BME-IIT-robotcsapat/iit-smallomni-pcb/iit-smallomni.pdf

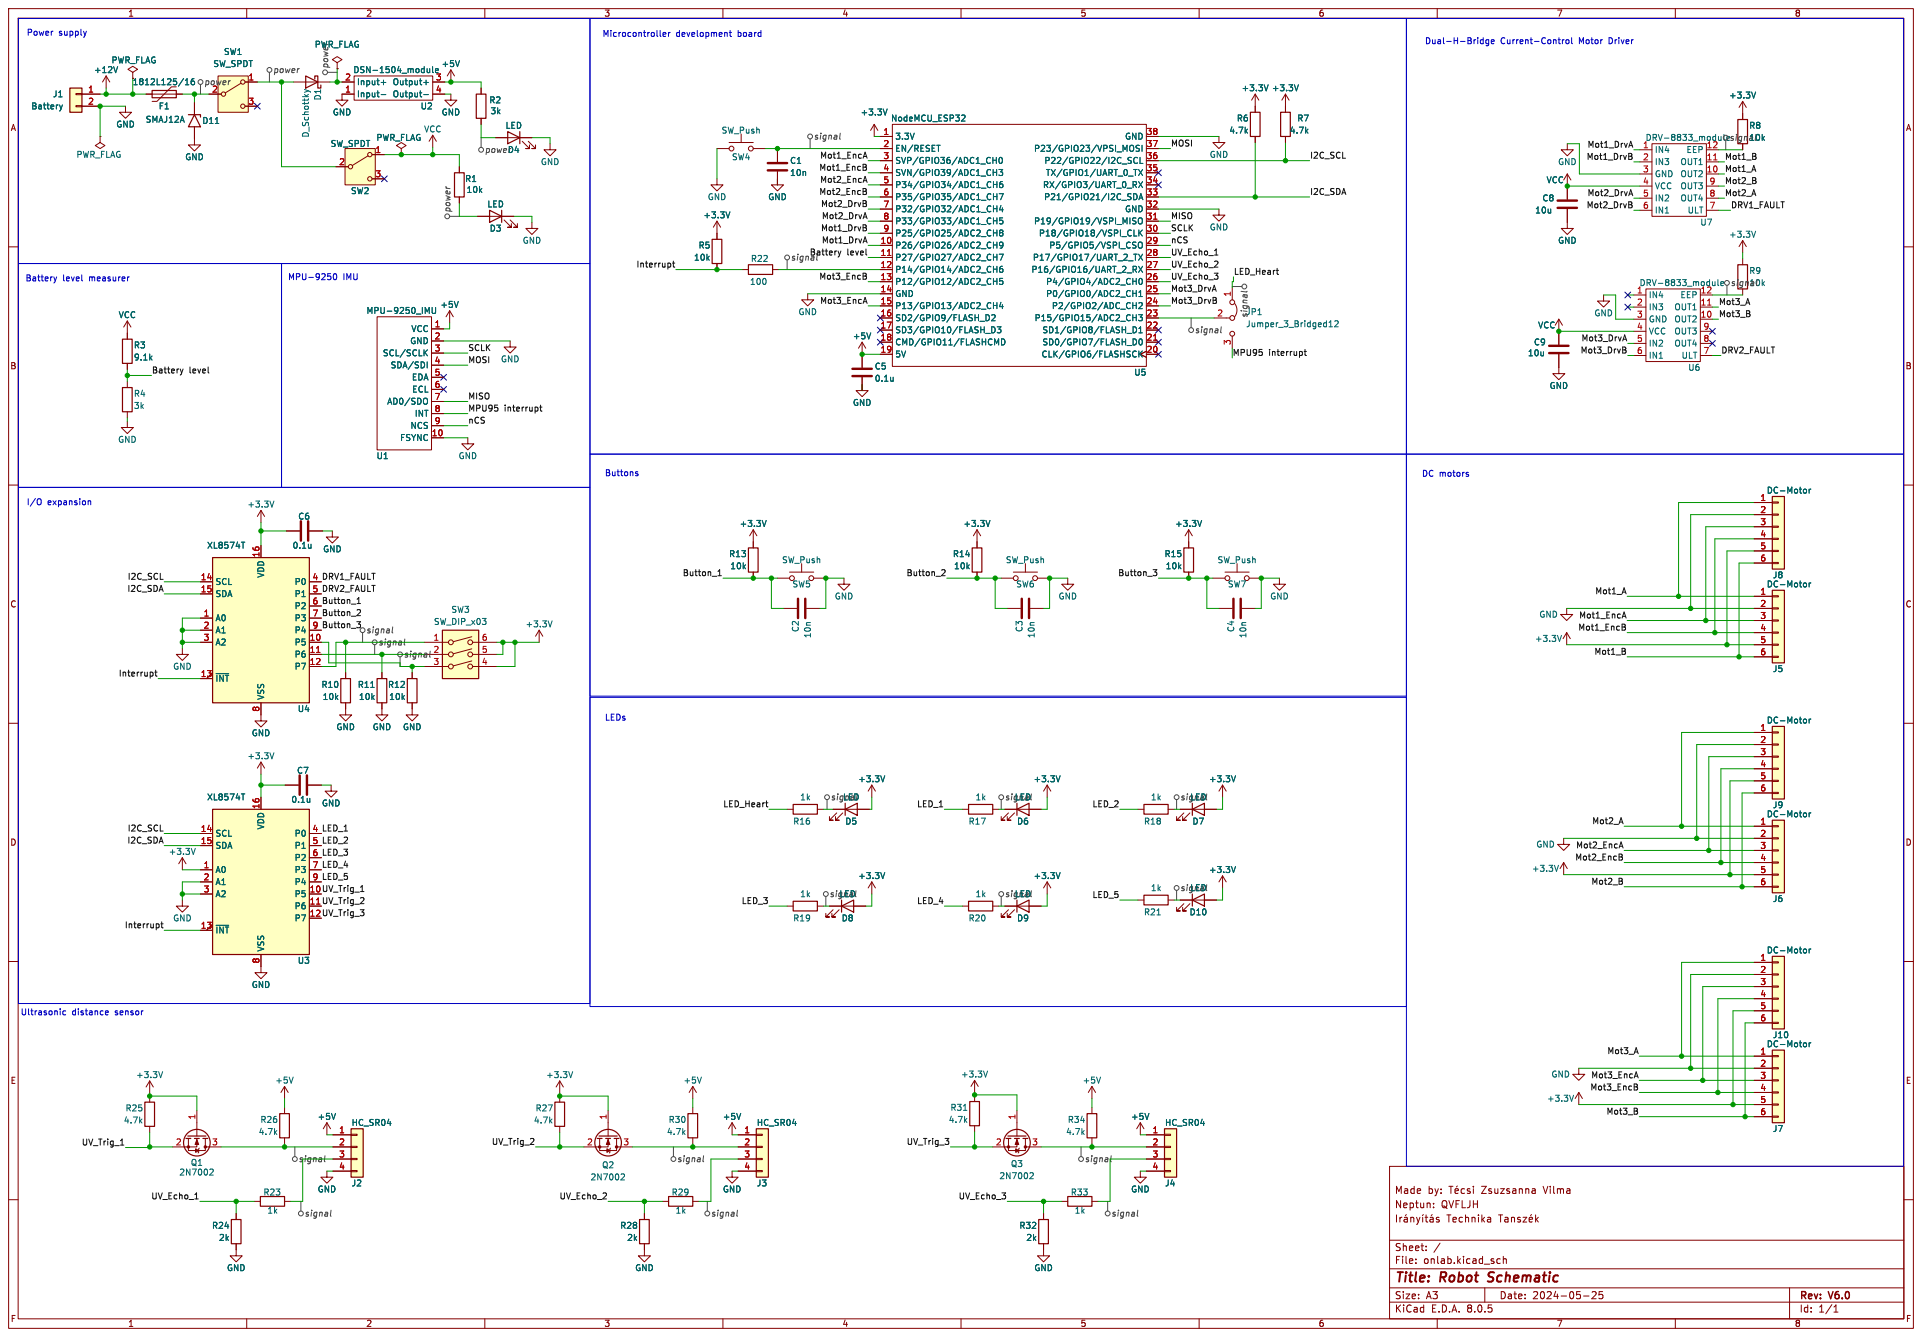
[picture p1: page 1]

LED
U1 MPU-9250_IMU
VCC 1 FSYNC 10 GND 2 SCL/SCLK 3 SDA/SDI 4 EDA 5 ECL 6 AD0/SDO 7

Id: 1/1 Title: Robot Schematic
