BME-IIT-robotcsapat/iit-smallomni-pcb/iit-smallomni.kicad_pcb

## KiCad design iit-smallomni.kicad_pcb (2025-07-06)

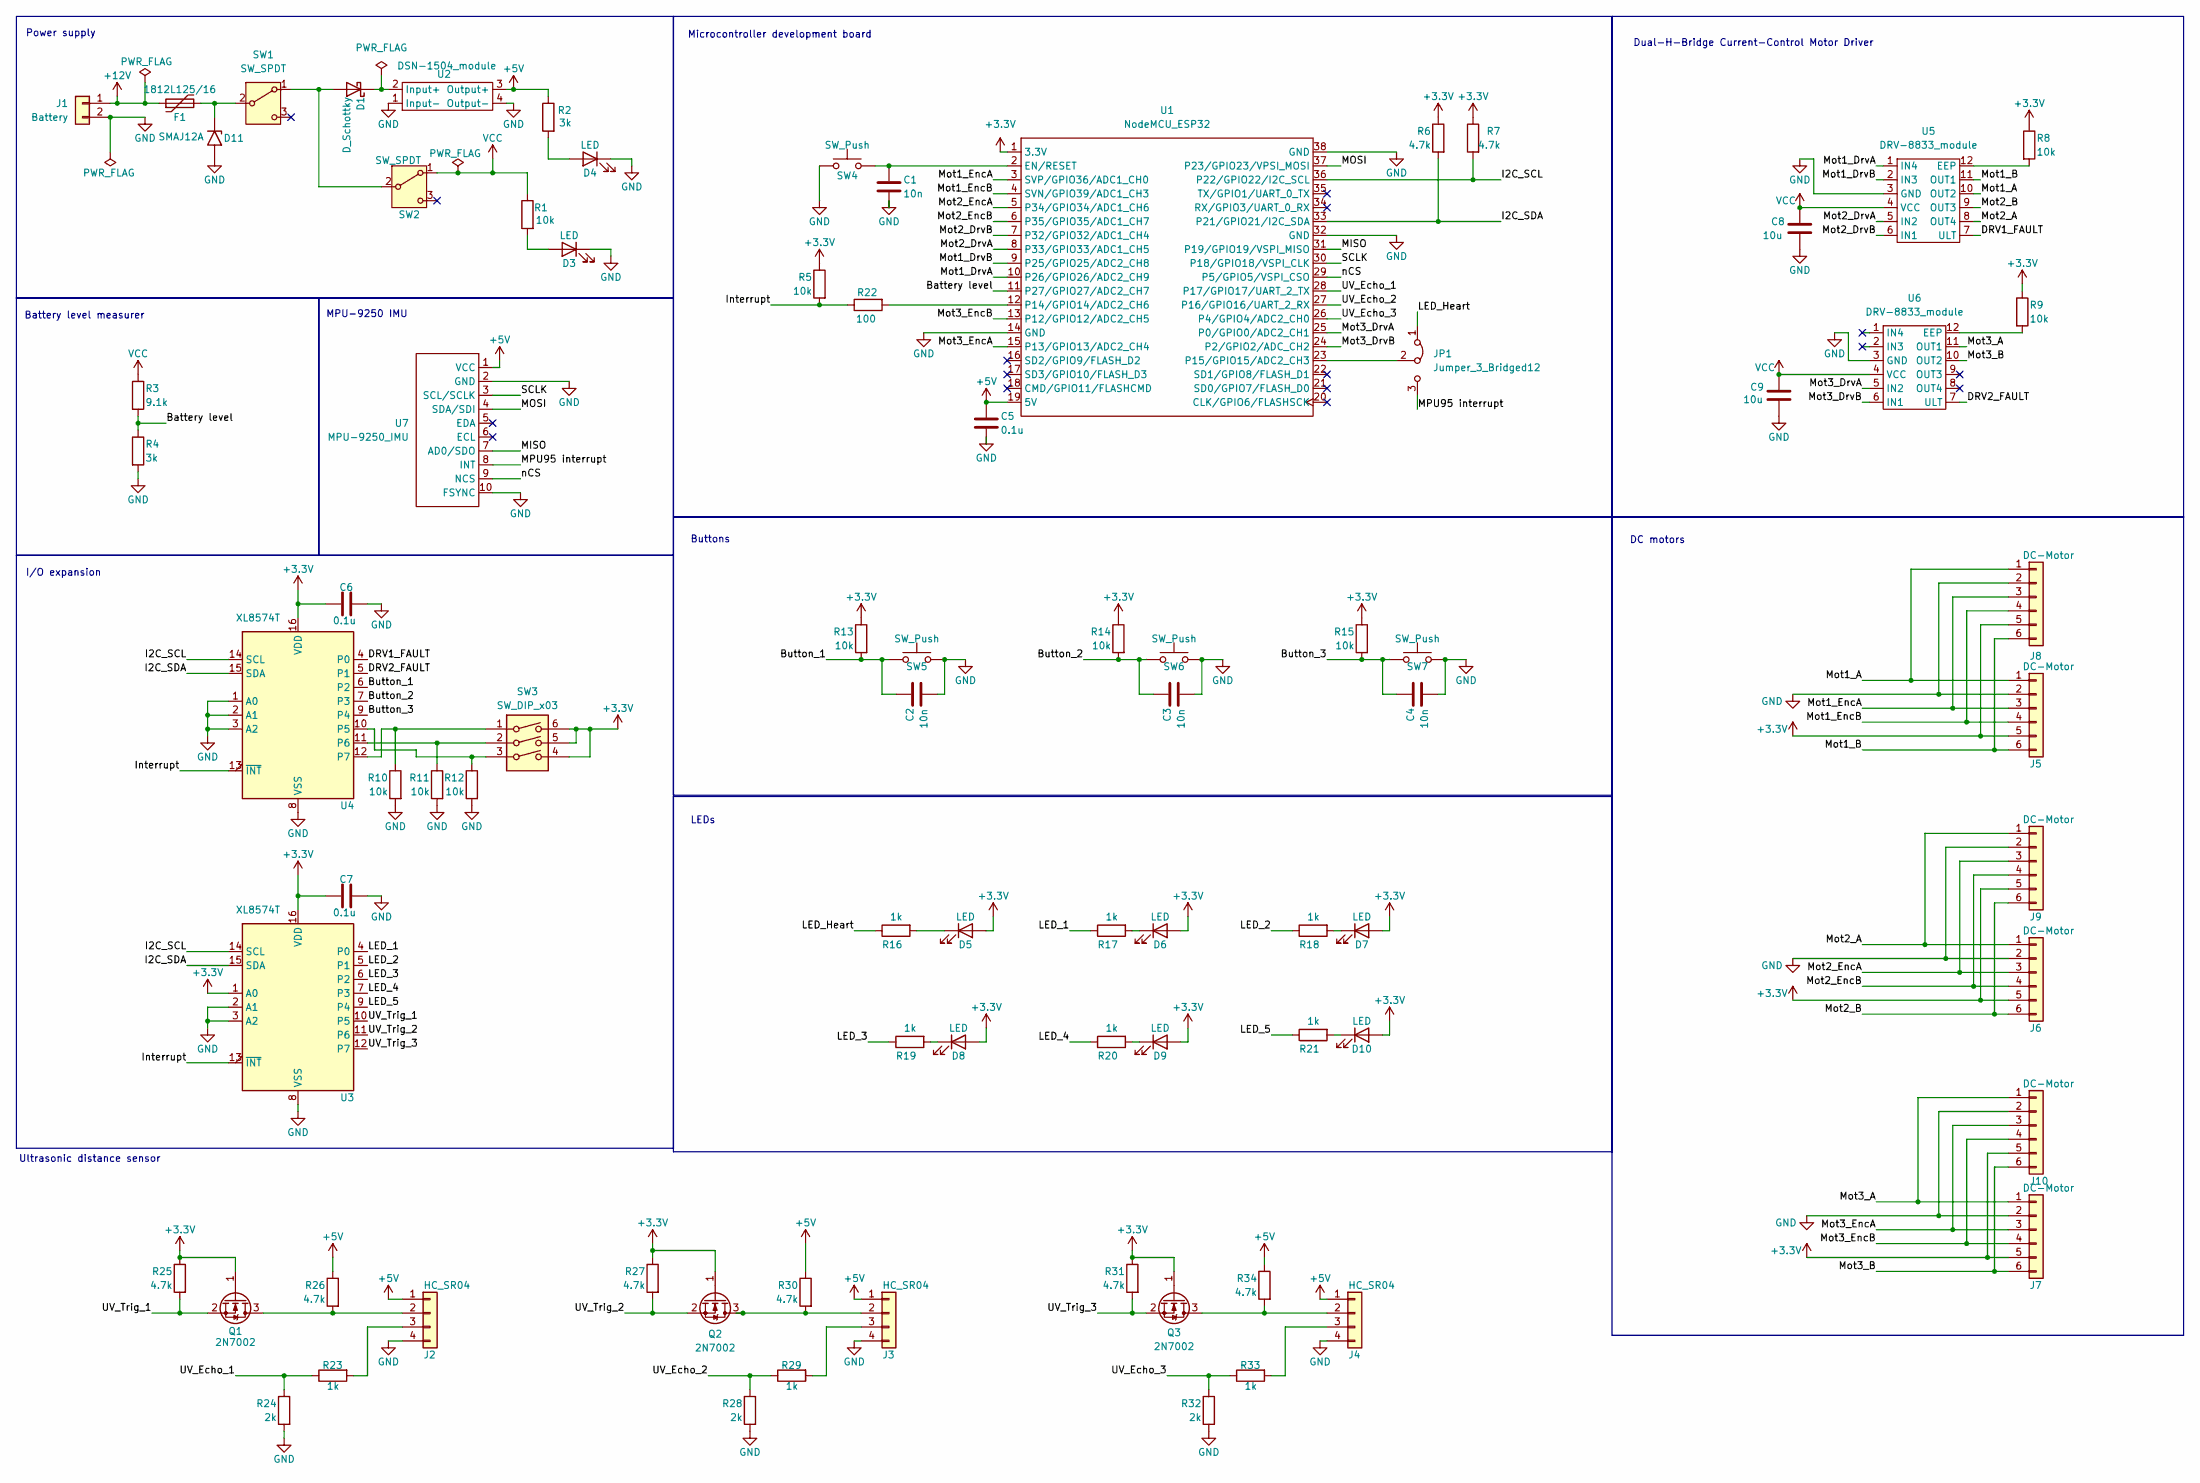
[picture p2: schematic iit-smallomni.kicad_sch, Robot Schematic]

Parts:
C1, C2, C3, C4: 10n; C_0805_2012Metric_Pad1.18x1.45mm_HandSolder
C5, C6, C7: 0.1u; C_0805_2012Metric_Pad1.18x1.45mm_HandSolder
C8, C9: 10u; C_0805_2012Metric_Pad1.18x1.45mm_HandSolder
D1: D_Schottky; D_0805_2012Metric_Pad1.15x1.40mm_HandSolder
D3, D4, D5, D6, D7, D8, D9, D10: LED; LED_0805_2012Metric_Pad1.15x1.40mm_HandSolder
D11: SMAJ12A; D_SMA
F1: 1812L125/16; polyfuse
J1: Battery; Molex_KK-254_AE-6410-02A_1x02_P2.54mm_Vertical
J2, J3, J4: HC_SR04; PinSocket_1x04_P2.54mm_Vertical
J5, J6, J7: DC-Motor; Molex_KK-254_AE-6410-06A_1x06_P2.54mm_Vertical
J8, J9, J10: DC-Motor; motor
JP1: Jumper_3_Bridged12; FanPinHeader_1x03_P2.54mm_Vertical
Q1, Q2, Q3: 2N7002; SOT-23
R1, R5, R8, R9, R10, R11, R12, R13, R14, R15: 10k; R_0805_2012Metric_Pad1.20x1.40mm_HandSolder
R2, R4: 3k; R_0805_2012Metric_Pad1.20x1.40mm_HandSolder
R3: 9.1k; R_0805_2012Metric_Pad1.20x1.40mm_HandSolder
R6, R7, R25, R26, R27, R30, R31, R34: 4.7k; R_0805_2012Metric_Pad1.20x1.40mm_HandSolder
R16, R17, R18, R19, R20, R21, R23, R29, R33: 1k; R_0805_2012Metric_Pad1.20x1.40mm_HandSolder
R22: 100; R_0805_2012Metric_Pad1.20x1.40mm_HandSolder
R24, R28, R32: 2k; R_0805_2012Metric_Pad1.20x1.40mm_HandSolder
SW1, SW2: SW_SPDT; FanPinHeader_1x03_P2.54mm_Vertical
SW3: SW_DIP_x03; SW_DIP_SPSTx03_Slide_9.78x9.8mm_W7.62mm_P2.54mm
SW4, SW5, SW6, SW7: SW_Push; SW_PUSH_6mm_H5mm
U1: NodeMCU_ESP32; NodeMCU32S
U2: DSN-1504_module; DSN1504_module
U3, U4: XL8574T; SOIC-16W_7.5x10.3mm_P1.27mm
U5, U6: DRV-8833_module
U7: MPU-9250_IMU; PinSocket_1x10_P2.54mm_Vertical

Connections:
+3.3V: C6.1, C7.1, D5.2 (A), D6.2 (A), D7.2 (A), D8.2 (A), D9.2 (A), D10.2 (A), J5.5, J6.5, J7.5, J8.5, J9.5, J10.5, Q1.1 (G), Q2.1 (G), Q3.1 (G), R5.1, R6.1, R7.1, R8.1, R9.1, R13.1, R14.1, R15.1, R25.1, R27.1, R31.1, SW3.4, SW3.5, SW3.6, U1.1 (3.3V), U3.1 (A0), U3.16 (VDD), U4.16 (VDD)
+5V: C5.1, J2.1, J3.1, J4.1, R2.1, R26.1, R30.1, R34.1, U1.19 (5V), U2.3 (Output+), U7.1 (VCC)
+12V: F1.1, J1.1
/Battery level: R3.2, R4.1, U1.11 (P27/GPIO27/ADC2_CH7)
/Button_1: C2.1, R13.2, SW5.1, U4.6 (P2)
/Button_2: C3.1, R14.2, SW6.1, U4.7 (P3)
/Button_3: C4.1, R15.2, SW7.1, U4.9 (P4)
/DRV1_FAULT: U4.4 (P0), U5.7 (ULT)
/DRV2_FAULT: U4.5 (P1), U6.7 (ULT)
/I2C_SCL: R7.2, U1.36 (P22/GPIO22/I2C_SCL), U3.14 (SCL), U4.14 (SCL)
/I2C_SDA: R6.2, U1.33 (P21/GPIO21/I2C_SDA), U3.15 (SDA), U4.15 (SDA)
/Interrupt: R5.2, R22.1, U3.13 (~INT), U4.13 (~INT)
/LED_1: R17.1, U3.4 (P0)
/LED_2: R18.1, U3.5 (P1)
/LED_3: R19.1, U3.6 (P2)
/LED_4: R20.1, U3.7 (P3)
/LED_5: R21.1, U3.9 (P4)
/LED_Heart: JP1.1 (A), R16.1
/MISO: U1.31 (P19/GPIO19/VSPI_MISO), U7.7 (AD0/SDO)
/MOSI: U1.37 (P23/GPIO23/VPSI_MOSI), U7.4 (SDA/SDI)
/MPU95 interrupt: JP1.3 (B), U7.8 (INT)
/Mot1_A: J5.1, J8.1, U5.10 (OUT2)
/Mot1_B: J5.6, J8.6, U5.11 (OUT1)
/Mot1_DrvA: U1.10 (P26/GPIO26/ADC2_CH9), U5.1 (IN4)
/Mot1_DrvB: U1.9 (P25/GPIO25/ADC2_CH8), U5.2 (IN3)
/Mot1_EncA: J5.3, J8.3, U1.3 (SVP/GPIO36/ADC1_CH0)
/Mot1_EncB: J5.4, J8.4, U1.4 (SVN/GPIO39/ADC1_CH3)
/Mot2_A: J6.1, J9.1, U5.8 (OUT4)
/Mot2_B: J6.6, J9.6, U5.9 (OUT3)
/Mot2_DrvA: U1.8 (P33/GPIO33/ADC1_CH5), U5.5 (IN2)
/Mot2_DrvB: U1.7 (P32/GPIO32/ADC1_CH4), U5.6 (IN1)
/Mot2_EncA: J6.3, J9.3, U1.5 (P34/GPIO34/ADC1_CH6)
/Mot2_EncB: J6.4, J9.4, U1.6 (P35/GPIO35/ADC1_CH7)
/Mot3_A: J7.1, J10.1, U6.11 (OUT1)
/Mot3_B: J7.6, J10.6, U6.10 (OUT2)
/Mot3_DrvA: U1.25 (P0/GPIO0/ADC2_CH1), U6.5 (IN2)
/Mot3_DrvB: U1.24 (P2/GPIO2/ADC_CH2), U6.6 (IN1)
/Mot3_EncA: J7.3, J10.3, U1.15 (P13/GPIO13/ADC2_CH4)
/Mot3_EncB: J7.4, J10.4, U1.13 (P12/GPIO12/ADC2_CH5)
/SCLK: U1.30 (P18/GPIO18/VSPI_CLK), U7.3 (SCL/SCLK)
/UV_Echo_1: R23.1, R24.1, U1.28 (P17/GPIO17/UART_2_TX)
/UV_Echo_2: R28.1, R29.1, U1.27 (P16/GPIO16/UART_2_RX)
/UV_Echo_3: R32.1, R33.1, U1.26 (P4/GPIO4/ADC2_CH0)
/UV_Trig_1: Q1.2 (S), R25.2, U3.10 (P5)
/UV_Trig_2: Q2.2 (S), R27.2, U3.11 (P6)
/UV_Trig_3: Q3.2 (S), R31.2, U3.12 (P7)
/nCS: U1.29 (P5/GPIO5/VSPI_CSO), U7.9 (NCS)
GND: C1.2, C2.2, C3.2, C4.2, C5.2, C6.2, C7.2, C8.2, C9.2, D3.1 (K), D4.1 (K), D11.2 (A2), J1.2, J2.4, J3.4, J4.4, J5.2, J6.2, J7.2, J8.2, J9.2, J10.2, R4.2, R10.2, R11.2, R12.2, R24.2, R28.2, R32.2, SW4.1, SW5.2, SW6.2, SW7.2, U1.14 (GND), U1.32 (GND), U1.38 (GND), U2.1 (Input-), U2.4 (Output-), U3.2 (A1), U3.3 (A2), U3.8 (VSS), U4.1 (A0), U4.2 (A1), U4.3 (A2), U4.8 (VSS), U5.3 (GND), U6.3 (GND), U7.2 (GND), U7.10 (FSYNC)
unnamed: D1.2 (A), SW1.1 (A), SW2.2 (B)
unnamed: D1.1 (K), U2.2 (Input+)
unnamed: D3.2 (A), R1.2
unnamed: D4.2 (A), R2.2
unnamed: D5.1 (K), R16.2
unnamed: D6.1 (K), R17.2
unnamed: D7.1 (K), R18.2
unnamed: D8.1 (K), R19.2
unnamed: D9.1 (K), R20.2
unnamed: D10.1 (K), R21.2
unnamed: D11.1 (A1), F1.2, SW1.2 (B)
unnamed: J2.2, Q1.3 (D), R26.2
unnamed: J2.3, R23.2
unnamed: J3.2, Q2.3 (D), R30.2
unnamed: J3.3, R29.2
unnamed: J4.2, Q3.3 (D), R34.2
unnamed: J4.3, R33.2
unnamed: JP1.2 (C), U1.23 (P15/GPIO15/ADC2_CH3)
unnamed: C1.1, SW4.2, U1.2 (EN/RESET)
unnamed: R22.2, U1.12 (P14/GPIO14/ADC2_CH6)
unnamed: R12.1, SW3.3, U4.10 (P5)
unnamed: R11.1, SW3.2, U4.11 (P6)
unnamed: R10.1, SW3.1, U4.12 (P7)
unnamed: R8.2, U5.12 (EEP)
unnamed: R9.2, U6.12 (EEP)
VCC: C8.1, C9.1, R1.1, R3.1, SW2.1 (A), U5.4 (VCC), U6.4 (VCC)

Notes on the sheet:
Ultrasonic distance sensor
LEDs
I/O expansion
Power supply
DC motors
Microcontroller development board
MPU-9250 IMU
Dual-H-Bridge Current-Control Motor Driver
Battery level measurer
Buttons

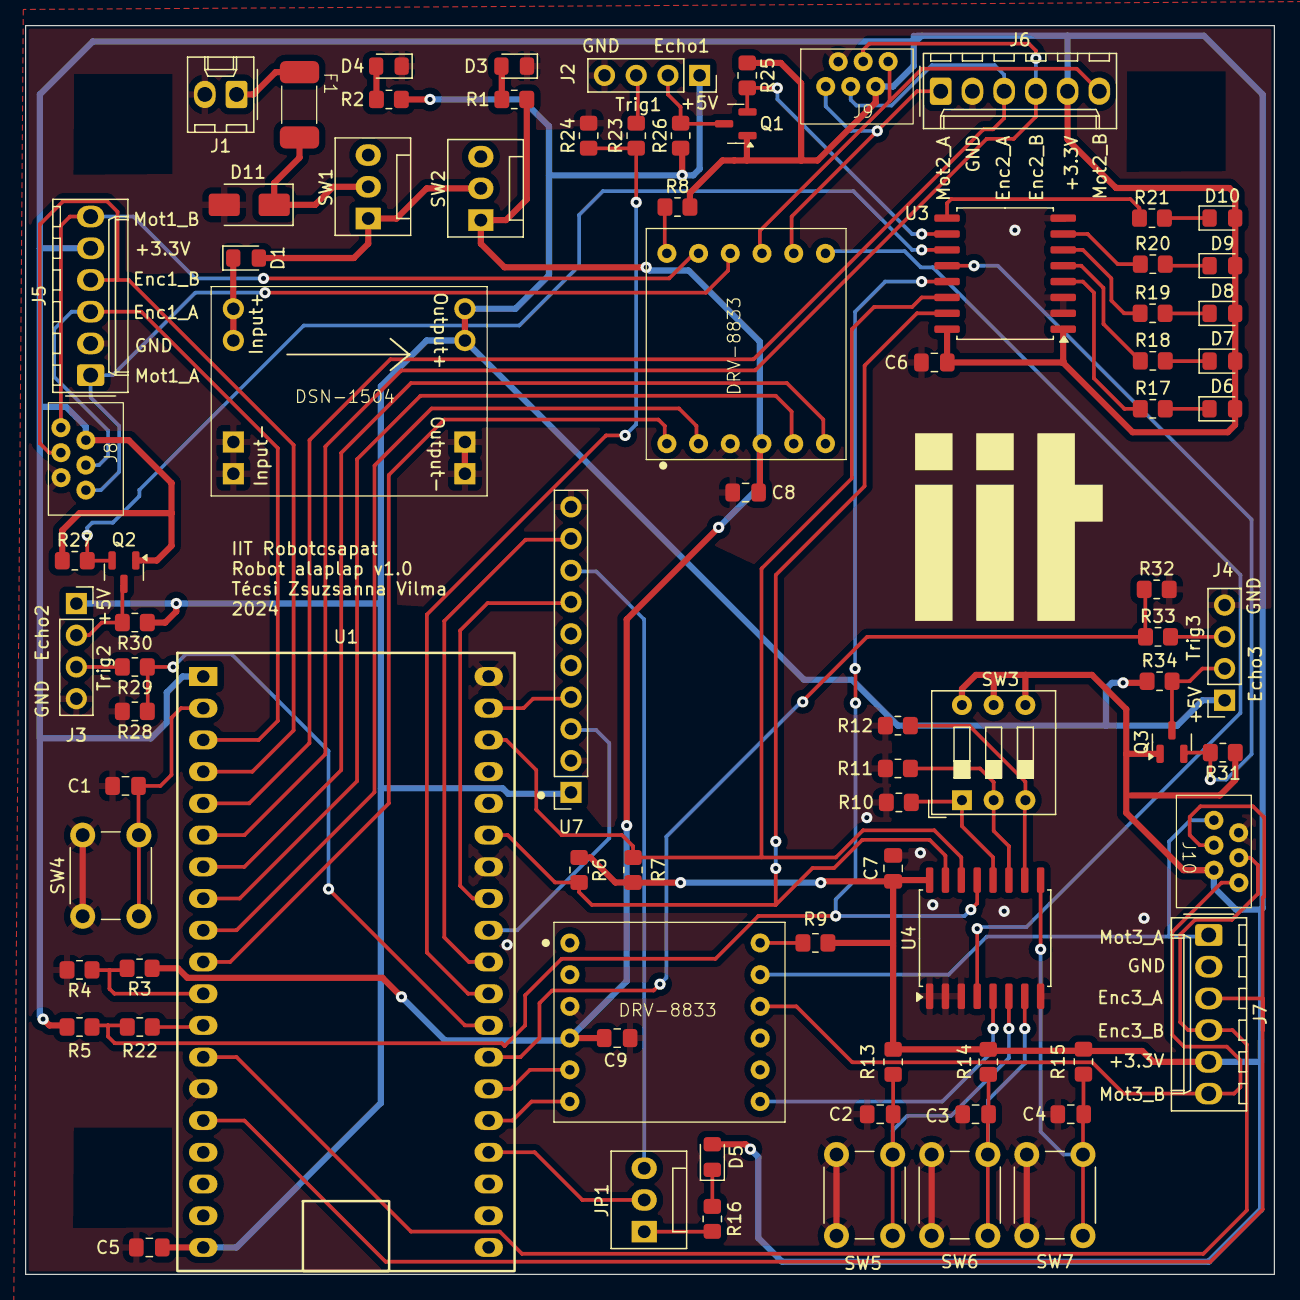
[picture p3: board iit-smallomni.kicad_pcb from above]

Board: 2 copper layers, 100.0 x 100.0 mm, 82 parts (0 on the bottom side), 74 nets.
