BME-IIT-robotcsapat/iit-smallomni-pcb/(threads)

Thread 1 (2024-10-10):

Schottky diode footprint mismatch

izsoandras, 2024-10-10:
0805 footprint has been used for the D1 Schottky diode. Replace it with appropriate footprint

Thread 2 (2024-11-15):

Legacy motor pinout mismatch

izsoandras, 2024-11-15:
The pin numbers do not fit with the one used on the old PCB (and the actual connections on the motors).

izsoandras, 2025-07-06:
https://github.com/BME-IIT-robotcsapat/iit-smallomni-pcb/commit/12b298a584159c76dacd98148207a98aa256cb53

Closed 2025-07-06.

Thread 3 (2024-11-15):

Add capacitor to RST-GND

izsoandras, 2024-11-15:
Add 10uF capacitor (or replace the 10nF debouncing one), so the device enters programming state automatically

Closed 2025-07-06.

Thread 5 (2024-11-19):

Dsn and DRV8833 footprint is upside down

izsoandras, 2024-11-19:
The pins are in reversed order, so the components had to be soldered upside down. Fix the pinout of the componenets

Closed 2025-07-06.

Thread 10 (2024-11-26):

Double check connection correctness after layout

izsoandras, 2024-11-26:
https://randomnerdtutorials.com/esp32-pinout-reference-gpios/

Closed 2025-07-17.

Thread 12 (2025-03-14):

Consider replacing DSN with fixed DC-DC converter

izsoandras, 2025-03-14:
According to György Rácz, the DSN module's potentiometer is prone to breaking or adjusting itself because of shaking. Replacing it with fixed output step down converter or replacing the potentiometer with fix resistor should be considered. Example replacement parts:
https://www.hestore.hu/prod_10038725.html#
https://www.hestore.hu/prod_10042763.html
https://www.hestore.hu/prod_10047207.html
