BME-IIT-robotcsapat/iit-smallomni-pcb/(commit log)

2024-04-30 first upload
    [onlab.kicad_pcb, onlab.kicad_sch]
2024-05-16 Schematic and footprint update
    [onlab.kicad_sch]
2024-05-16 resistor value
    [onlab.kicad_sch]
2024-05-20 schematic update
    [onlab.kicad_sch]
2024-05-20 schematic update: dc motor connectors
    [onlab.kicad_sch]
2024-09-04 footprint assignment final
    [onlab.kicad_sch]
2024-09-09 motor footprint update
    [onlab.kicad_pcb, onlab.kicad_sch]
2024-09-14 layout v2
    [onlab.kicad_pcb, onlab.kicad_sch]
2024-09-16 Routing part 2
    [onlab.kicad_pcb, onlab.kicad_sch]
2024-09-16 Routing part 3 - remain to be done motors and vcc
    [onlab.kicad_pcb, onlab.kicad_sch]
2024-09-16 Routing part 4 - remain to be done GND and GNDPWR
    [onlab.kicad_pcb, onlab.kicad_sch]
2024-09-18 Layout finish
    [onlab.kicad_pcb]
2024-09-18 schematic and layout pdf
2024-09-23 Correction of schematic and layout
    [onlab.kicad_pcb, onlab.kicad_sch]
2024-09-24 Correction of Q1, Q2, Q3 and update of libraries
    [onlab.kicad_pcb, onlab.kicad_sch]
2024-09-25 keep out area update, pdf update
    [onlab.kicad_pcb]
2024-10-04 resistor value update
    [onlab.kicad_sch]
2024-10-04 resistor value update 2
    [onlab.kicad_sch]
2025-07-06 Clean up names, schematic grid and files
    [iit-smallomni.kicad_pcb, iit-smallomni.kicad_sch, onlab.kicad_sch]
2025-07-06 Change reset capacitor to 10uF
    [iit-smallomni.kicad_sch]
